UBCO-Motorsports/ShiftController2020/KiCad_Project/ShiftControllerV2.kicad_pcb

## KiCad design KiCad_Project/ShiftControllerV2.kicad_pcb (2020-01-30)

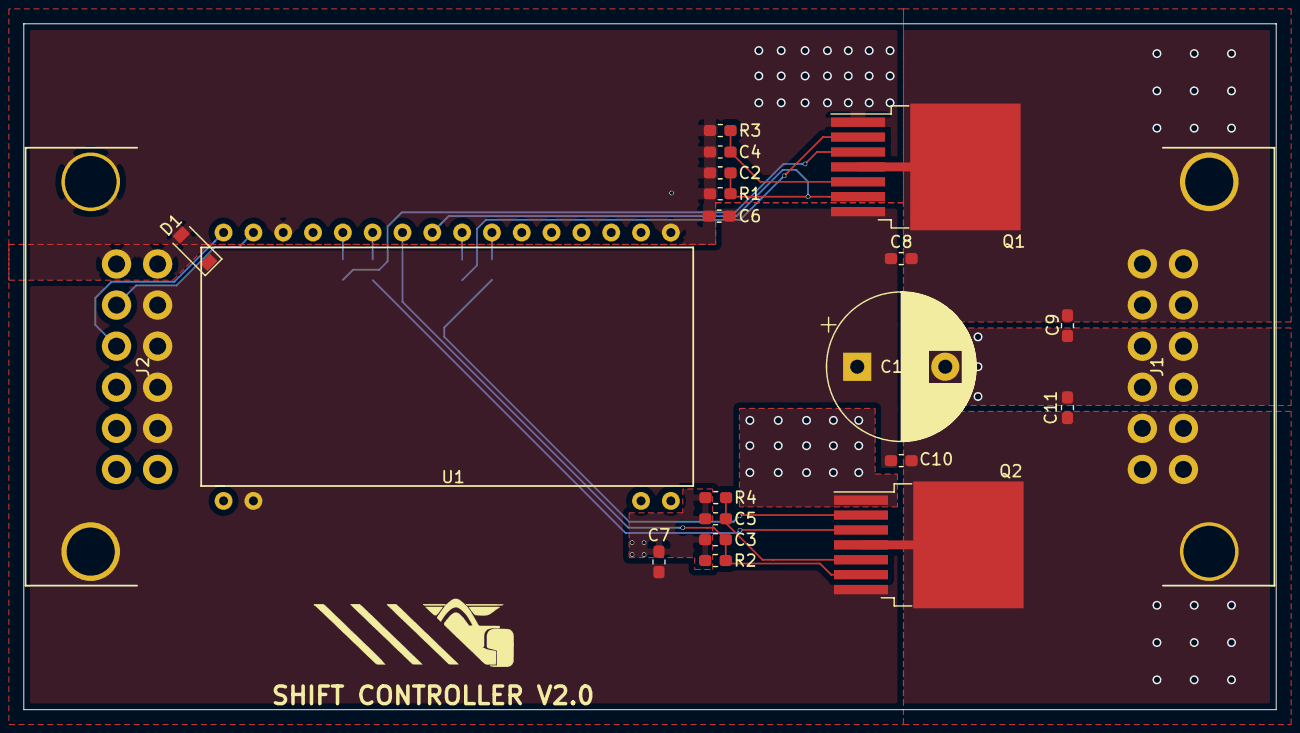
[picture p1: board ShiftControllerV2.kicad_pcb from above]

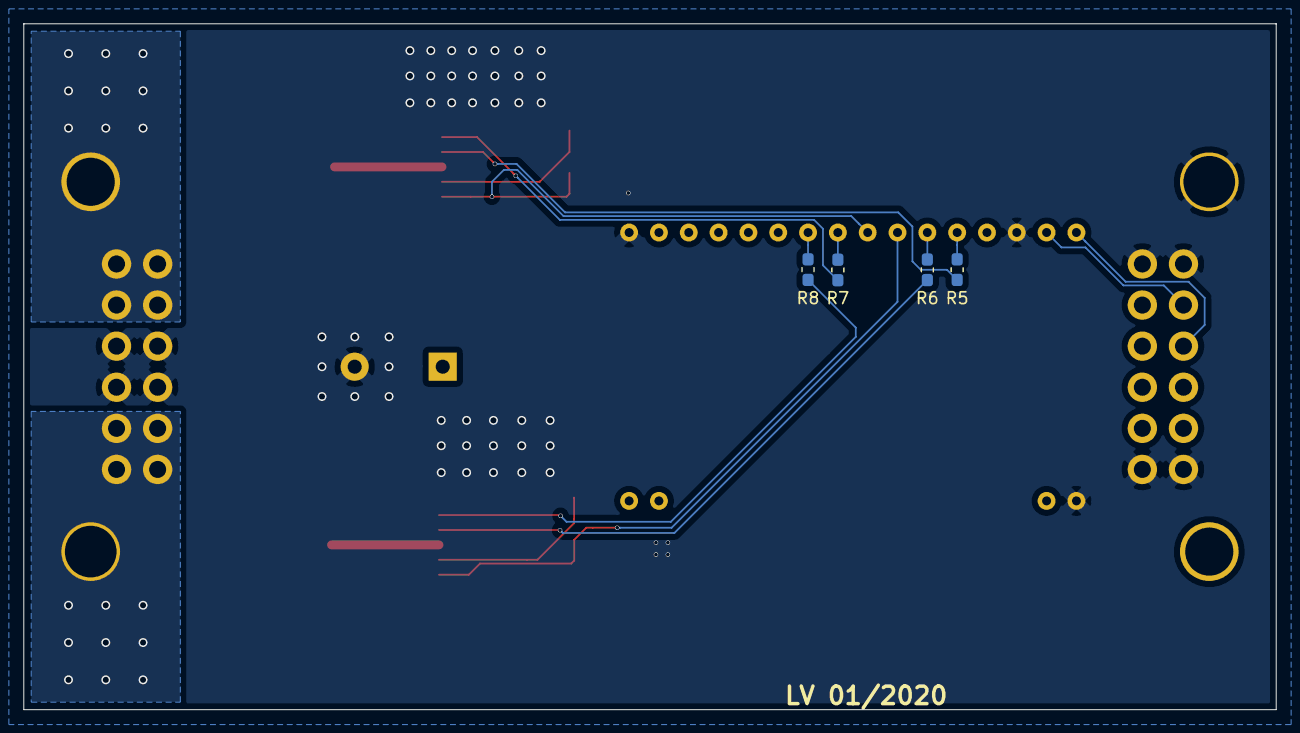
[picture p2: board ShiftControllerV2.kicad_pcb from below]

Board: 2 copper layers, 106.7 x 58.4 mm, 25 parts (4 on the bottom side), 18 nets.

Parts:
C1: 1000u; CP_Radial_D12.5mm_P7.50mm
C2, C3: 1n; C_0603_1608Metric_Pad1.05x0.95mm_HandSolder
C4, C5, C6, C7: 100n; C_0603_1608Metric_Pad1.05x0.95mm_HandSolder
C8, C9, C10, C11: 220n; C_0603_1608Metric_Pad1.05x0.95mm_HandSolder
D1: 30v zener; D_SOD-123
J1, J2: Conn_02x06_Top_Bottom; MX120G
Q1, Q2: BTN8982TA; TO-263-7_TabPin8
R1, R2, R3, R4: 510; R_0603_1608Metric_Pad1.05x0.95mm_HandSolder
R5, R6, R7, R8: 10k; R_0603_1608Metric_Pad1.05x0.95mm_HandSolder
U1: ControllerBoardV1; Breadboard_Center_32pin

Connections:
+12V: C1.1, C6.1, C7.1, C8.1, C10.1, D1.1, J2.2, J2.3, J2.4, J2.5, J2.13, Q1.7, Q2.7, U1.2
CANH: J2.8, U1.18
CANL: J2.9, U1.17
CURRENT1: C2.1, Q1.6, R1.1, U1.24
CURRENT2: C3.1, Q2.6, R2.1, U1.23
GND: C1.2, C2.2, C3.2, C4.2, C5.2, C6.2, C7.2, C9.2, C11.2, D1.2, J1.3, J1.4, J1.9, J1.10, J2.1, J2.6, J2.7, J2.12, J2.13, Q1.1, Q2.1, R1.2, R2.2, R3.2, R4.2, U1.1, U1.19, U1.32
IN1: Q1.2, R7.1
IN2: Q2.2, R8.1
INH1: Q1.3, R5.1
INH2: Q2.3, R6.1
unnamed: C4.1, Q1.5, R3.1
unnamed: C5.1, Q2.5, R4.1
unnamed: R5.2, U1.21
unnamed: R6.2, U1.22
unnamed: R7.2, U1.25
unnamed: R8.2, U1.26
OUT1: C8.2, C9.1, J1.5, J1.6, J1.11, J1.12, J1.13, Q1.4, Q1.8
OUT2: C10.2, C11.1, J1.1, J1.2, J1.7, J1.8, J1.13, Q2.4, Q2.8
