UBCO-Motorsports/ShiftController2020/(commit log)

2019-11-20 Added entire kicad project
    [ShiftControllerV2.kicad_pcb, ShiftControllerV2.sch]
2019-11-25 Began planning arrangement of components
    [ShiftControllerV2.kicad_pcb, ShiftControllerV2.sch]
2020-01-16 Layout almost complete
    [ShiftControllerV2.kicad_pcb, ShiftControllerV2.sch]
2020-01-30 V1 Complete and out for manufacturing
    [ShiftControllerV2.kicad_pcb]
2020-01-30 Exported Step file
    [ShiftControllerV2.kicad_pcb]
2020-02-03 First code upload
    Both LPIT channels implemented. Base logic implemented. CAN filtering setup.
2020-02-15 Improvements on CAN receiving and fixed LPIT start/stop
    [main.c]
